hslu-aprog/aprog-hat/supplementary/contents_kit.jpg

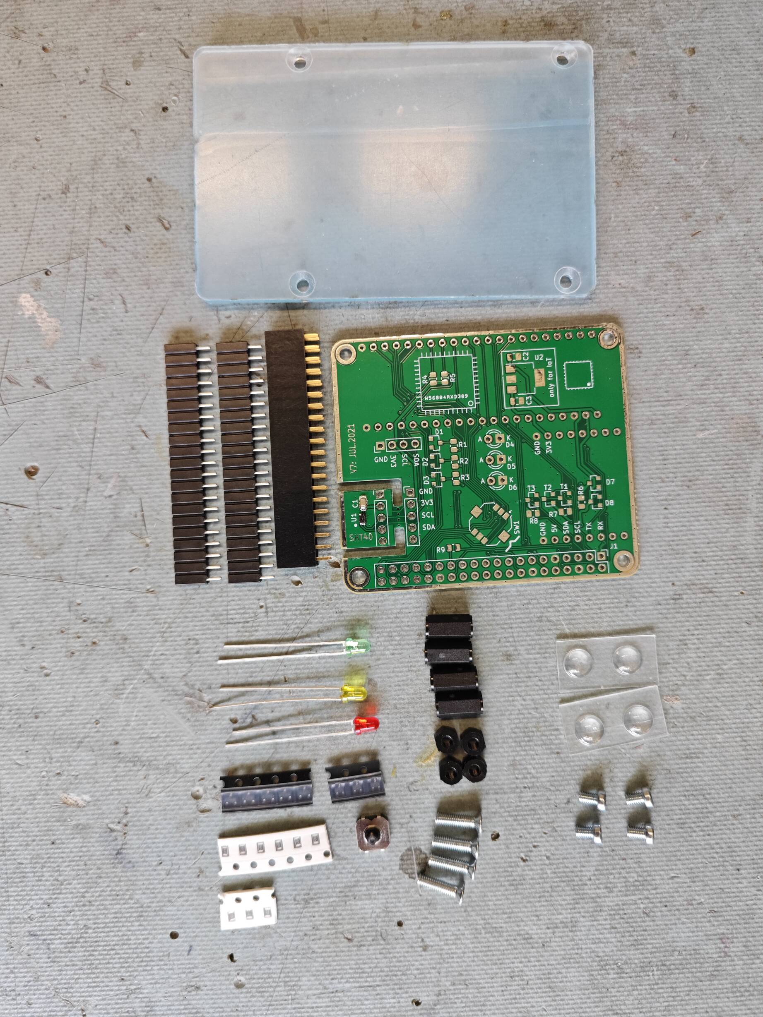
supplementary/contents_kit.jpg
