hslu-aprog/aprog-hat/supplementary/Raspi_Plexi_simple_elong.pdf

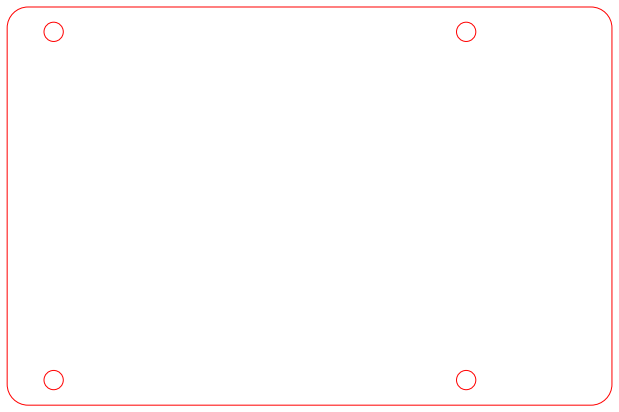
[picture p2: figure]
