hslu-aprog/aprog-hat/supplementary/etikett.png

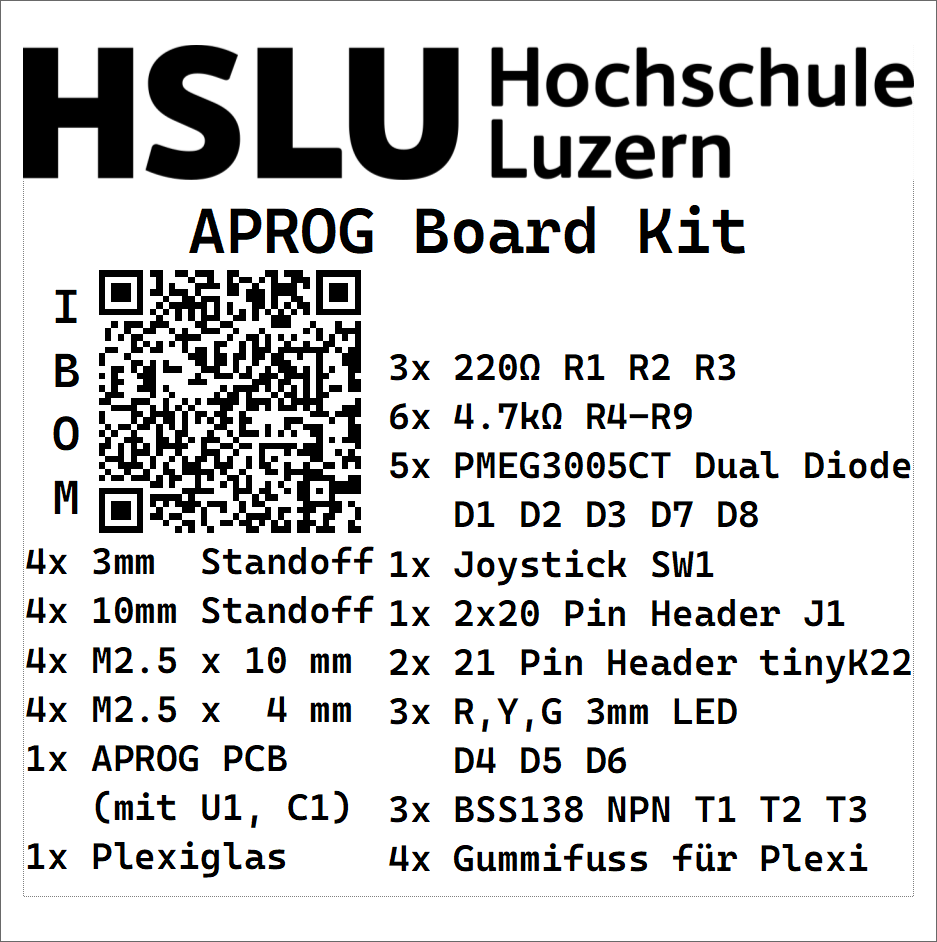
supplementary/etikett.png
