hslu-aprog/aprog-hat/case/bottom_plate.step

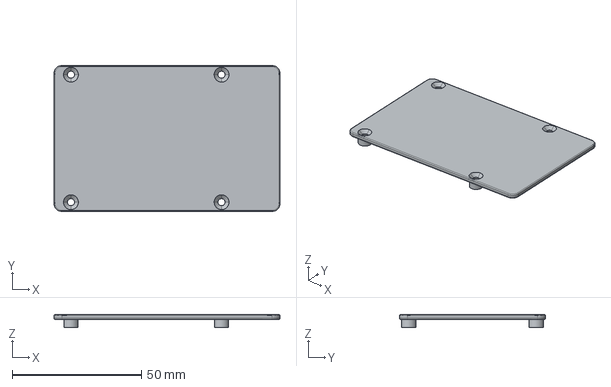
[picture p4: CAD file, 2026-08-25]
case/bottom_plate.step
87.5 x 56.4 x 5.00 mm
