hslu-aprog/aprog-hat/(list of files, cad)

Other CAD files:
case/bottom_plate.3mf
case/bottom_plate.FCStd
