hslu-aprog/aprog-hat/hat_rev8/hat_rev8.kicad_pcb

## KiCad design hat_rev8/hat_rev8.kicad_pcb (2026-07-09)

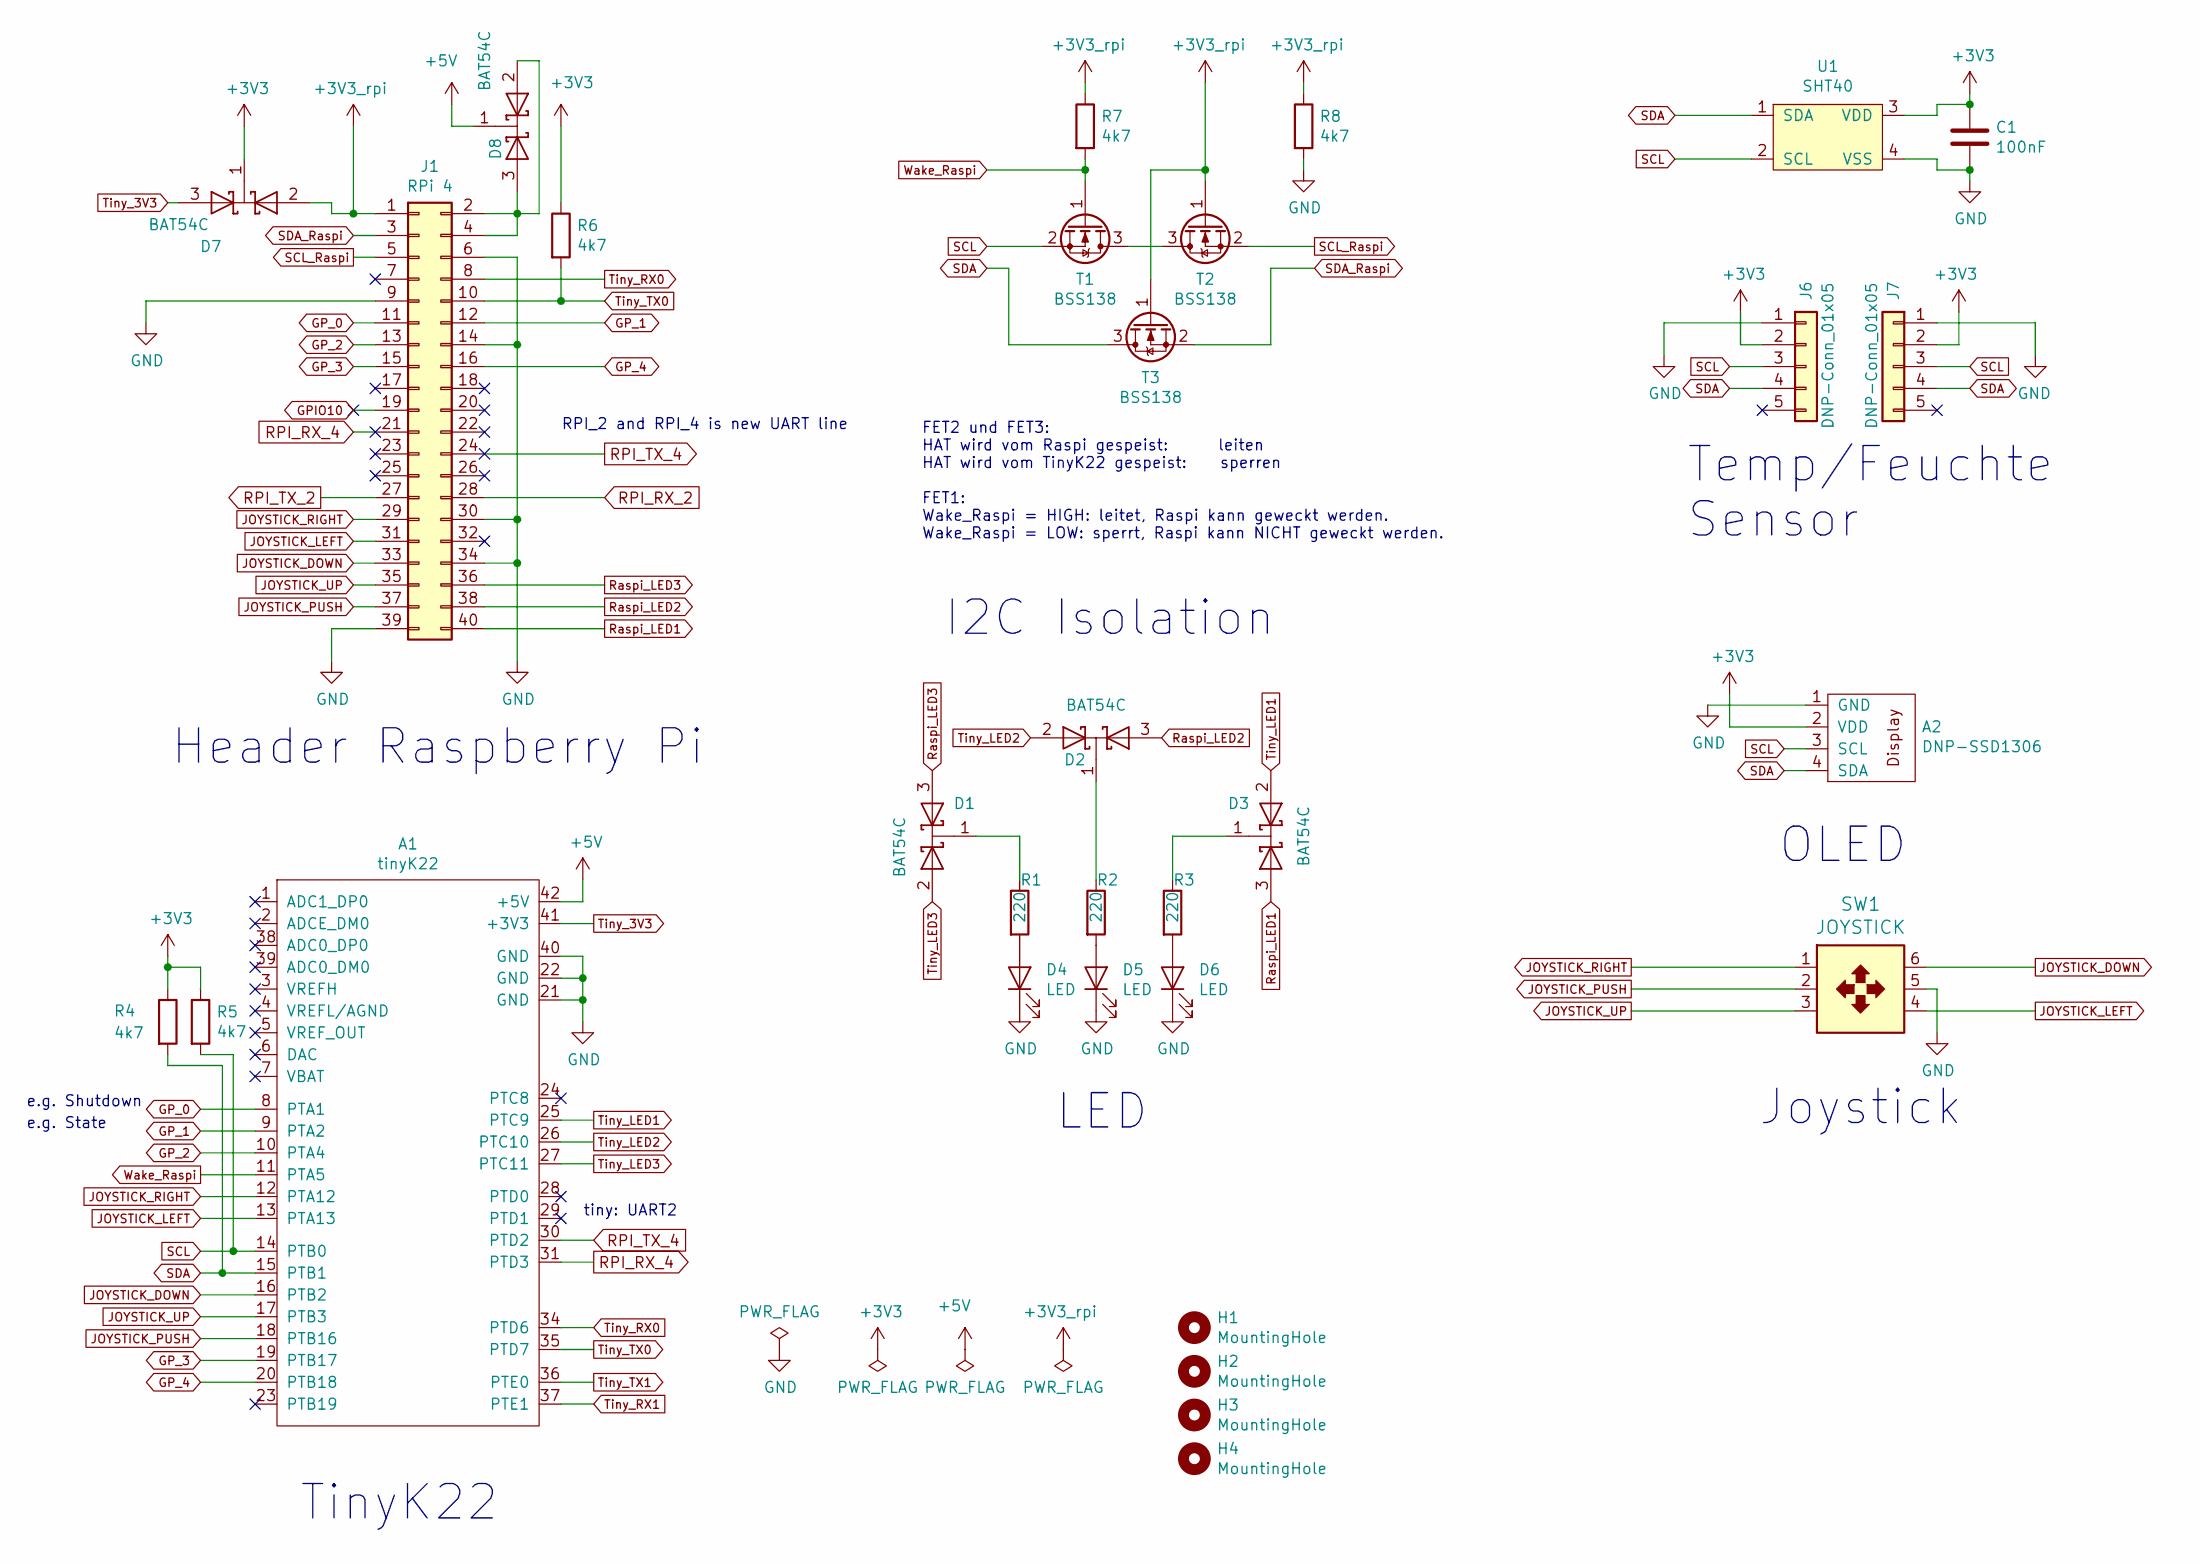
[picture p5: schematic hat_rev8.kicad_sch, APROG - Raspberry Pi HAT]

Parts:
A1: tinyK22
A2: DNP-SSD1306; SSD1306
C1: 100nF; C_0805_2012Metric
D1, D2, D3, D7, D8: BAT54C; D_SOT-23_ANK
D4, D5, D6: LED; LED_D3.0mm
H1, H2, H3, H4: MountingHole; MountingHole_2.7mm_M2.5_ISO7380_Pad
J1: RPi 4; PinHeader_2x20_P2.54mm_Vertical
J6, J7: DNP-Conn_01x05; PinHeader_1x05_P2.54mm_Vertical
R1, R2, R3: 220; R_0805_2012Metric
R4, R5, R6, R7, R8: 4k7; R_0805_2012Metric
SW1: JOYSTICK; Joystick
T1, T2, T3: BSS138; SOT-23
U1: SHT40

Connections:
+3V3: A2.2 (VDD), C1.1, D7.1 (K), J6.2, J7.2, R4.1, R5.1, R6.1, U1.3 (VDD)
+3V3_rpi: D7.2 (A), J1.1, R7.1, R8.1, T2.1 (G), T3.1 (G)
+5V: A1.42 (+5V), D8.1 (K)
GND: A1.21 (GND), A1.22 (GND), A1.40 (GND), A2.1 (GND), C1.2, D4.1 (K), D5.1 (K), D6.1 (K), J1.6, J1.9, J1.14, J1.30, J1.34, J1.39, J6.1, J7.1, R8.2, SW1.5, U1.4 (VSS)
GPIO10: J1.19
GP_0: A1.8 (PTA1), J1.11
GP_1: A1.9 (PTA2), J1.12
GP_2: A1.10 (PTA4), J1.13
GP_3: A1.19 (PTB17), J1.15
GP_4: A1.20 (PTB18), J1.16
JOYSTICK_DOWN: A1.16 (PTB2), J1.33, SW1.6
JOYSTICK_LEFT: A1.13 (PTA13), J1.31, SW1.4
JOYSTICK_PUSH: A1.18 (PTB16), J1.37, SW1.2
JOYSTICK_RIGHT: A1.12 (PTA12), J1.29, SW1.1
JOYSTICK_UP: A1.17 (PTB3), J1.35, SW1.3
unnamed: D1.1 (K), R1.1
unnamed: D2.1 (K), R2.1
unnamed: D3.1 (K), R3.1
unnamed: D4.2 (A), R1.2
unnamed: D5.2 (A), R2.2
unnamed: D6.2 (A), R3.2
unnamed: D8.2 (A), D8.3 (A), J1.2, J1.4
unnamed: T1.3 (D), T2.3 (D)
RPI_RX_2: J1.28
RPI_RX_4: A1.31 (PTD3), J1.21
RPI_TX_2: J1.27
RPI_TX_4: A1.30 (PTD2), J1.24
Raspi_LED1: D3.3 (A), J1.40
Raspi_LED2: D2.3 (A), J1.38
Raspi_LED3: D1.3 (A), J1.36
SCL: A1.14 (PTB0), A2.3 (SCL), J6.3, J7.3, R5.2, T1.2 (S), U1.2 (SCL)
SCL_Raspi: J1.5, T2.2 (S)
SDA: A1.15 (PTB1), A2.4 (SDA), J6.4, J7.4, R4.2, T3.3 (D), U1.1 (SDA)
SDA_Raspi: J1.3, T3.2 (S)
Tiny_3V3: A1.41 (+3V3), D7.3 (A)
Tiny_LED1: A1.25 (PTC9), D3.2 (A)
Tiny_LED2: A1.26 (PTC10), D2.2 (A)
Tiny_LED3: A1.27 (PTC11), D1.2 (A)
Tiny_RX0: A1.34 (PTD6), J1.8
Tiny_RX1: A1.37 (PTE1)
Tiny_TX0: A1.35 (PTD7), J1.10, R6.2
Tiny_TX1: A1.36 (PTE0)
Wake_Raspi: A1.11 (PTA5), R7.2, T1.1 (G)

Notes on the sheet:
tiny: UART2
LED
Joystick
OLED
I2C Isolation
e.g. State
Temp/Feuchte Sensor
Header Raspberry Pi
FET2 und FET3: HAT wird vom Raspi gespeist: leiten HAT wird vom TinyK22 gespeist: sperren FET1: Wake_Raspi = HIGH: leitet, Raspi kann geweckt werden. Wake_Raspi = LOW: sperrt, Raspi kann NICHT geweckt werden.
e.g. Shutdown
TinyK22
RPI_2 and RPI_4 is new UART line

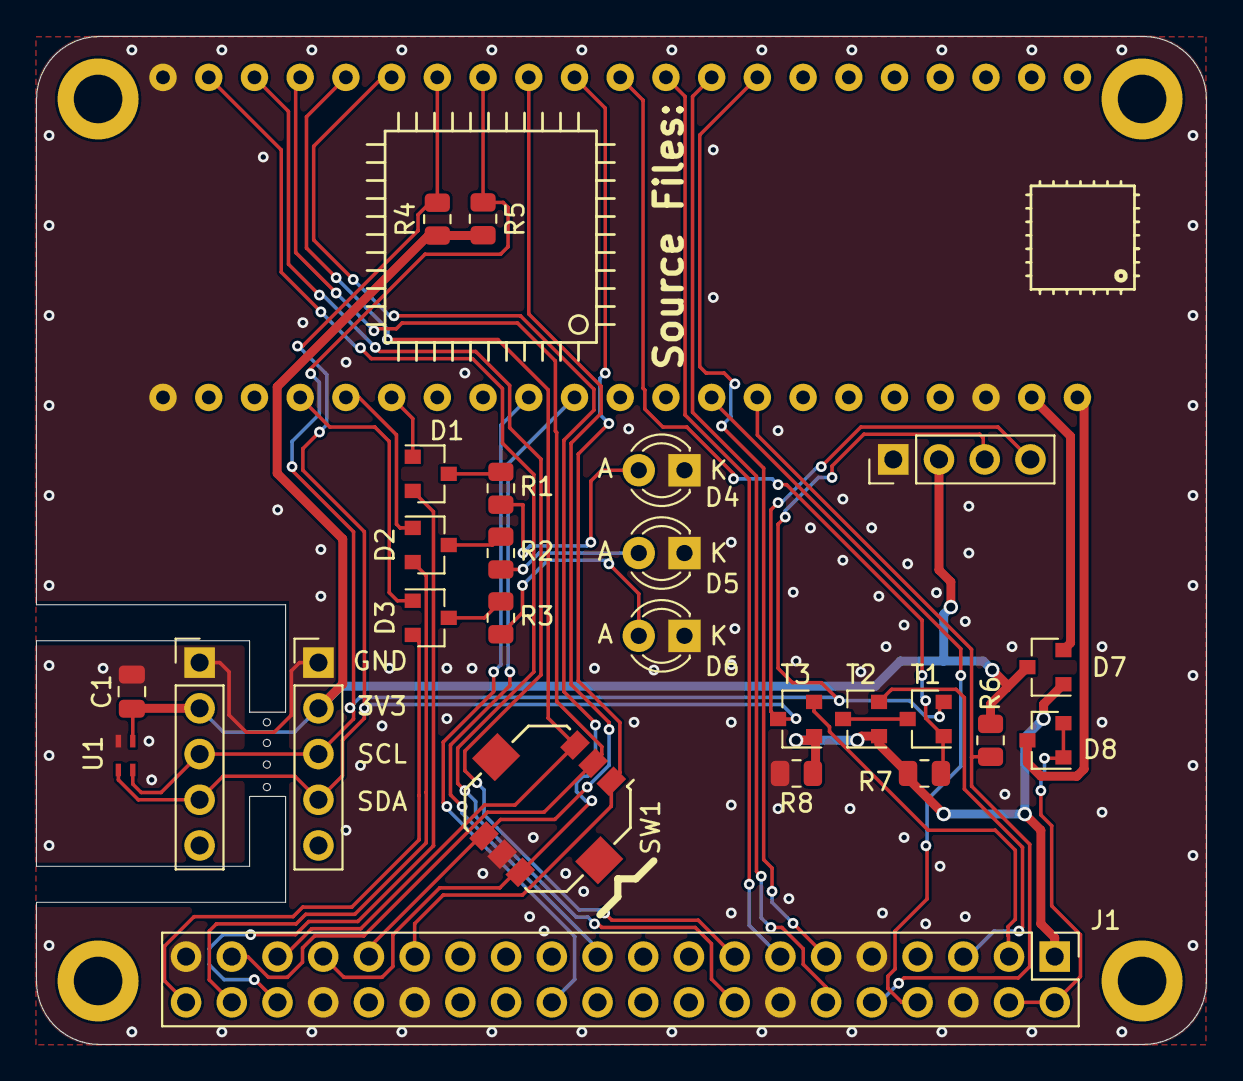
[picture p6: board hat_rev8.kicad_pcb from above]

Board: 2 copper layers, 65.0 x 56.0 mm, 31 parts (0 on the bottom side), 38 nets.
