hslu-aprog/aprog-hat/(commit log)

2026-07-09 add rev8 version
    [hat_rev8.kicad_pcb, hat_rev8.kicad_sch]
2026-07-09 remove old unneeded parts
    [hat_rev8.kicad_pcb]
2026-07-09 change PCB marking to V8
    [hat_rev8.kicad_pcb]
2026-07-09 add source file reference
    [hat_rev8.kicad_pcb]
2026-07-09 Finish v8
    [hat_rev8.kicad_pcb]
2026-07-09 remove mystery keepout
    [hat_rev8.kicad_pcb]
2026-07-09 move JLC text to right side bottom
    [hat_rev8.kicad_pcb]
2026-07-09 add bling
    [hat_rev8.kicad_pcb]
2026-07-09 update date and rev number
    [hat_rev8.kicad_pcb, hat_rev8.kicad_sch]
2026-07-09 update dual diode to BAT54C
    [hat_rev8.kicad_pcb, hat_rev8.kicad_sch]
2026-07-09 update landing page and IBOMs to show both rev7 and rev8
2026-08-25 add case source
    [bottom_plate.3mf, bottom_plate.FCStd, bottom_plate.step]
